MohamedAmr1312/3D-scanner/3D Scanner electrical system/3D Scanner_V02.png

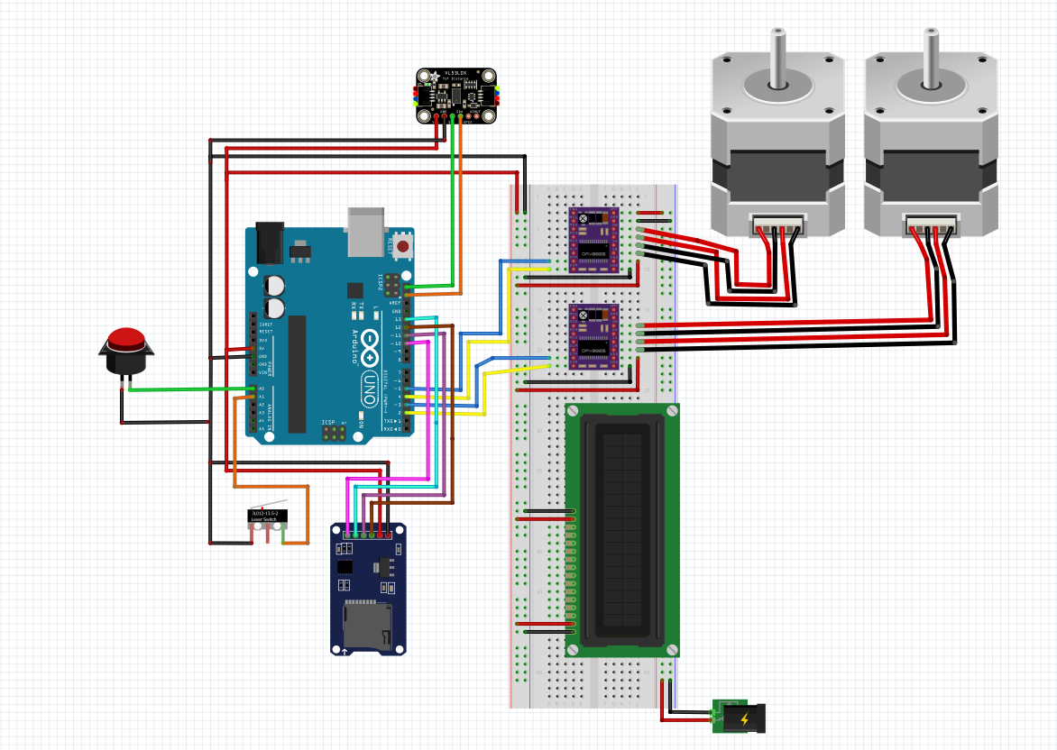
3D Scanner electrical system/3D Scanner_V02.png
