MohamedAmr1312/3D-scanner/mechanical design/3d scanner full/3d scanner full/stepper-motors-nema-23-1.snapshot.5/image.jpg

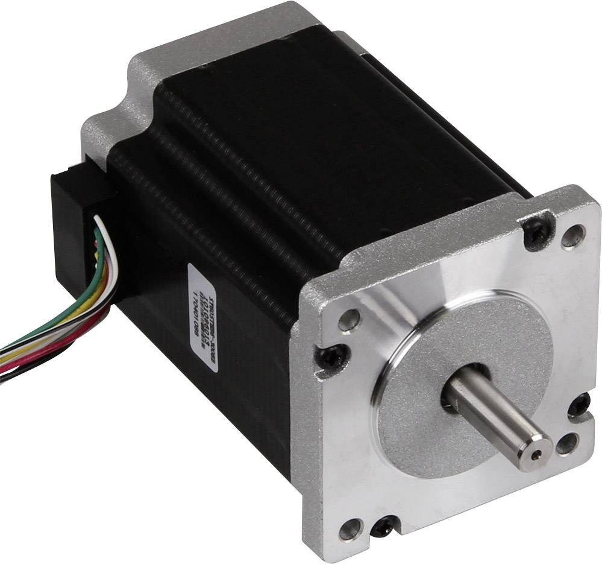
mechanical design/3d scanner full/3d scanner full/stepper-motors-nema-23-1.snapshot.5/image.jpg
