MohamedAmr1312/3D-scanner/Screenshot 2025-04-29 000141.png

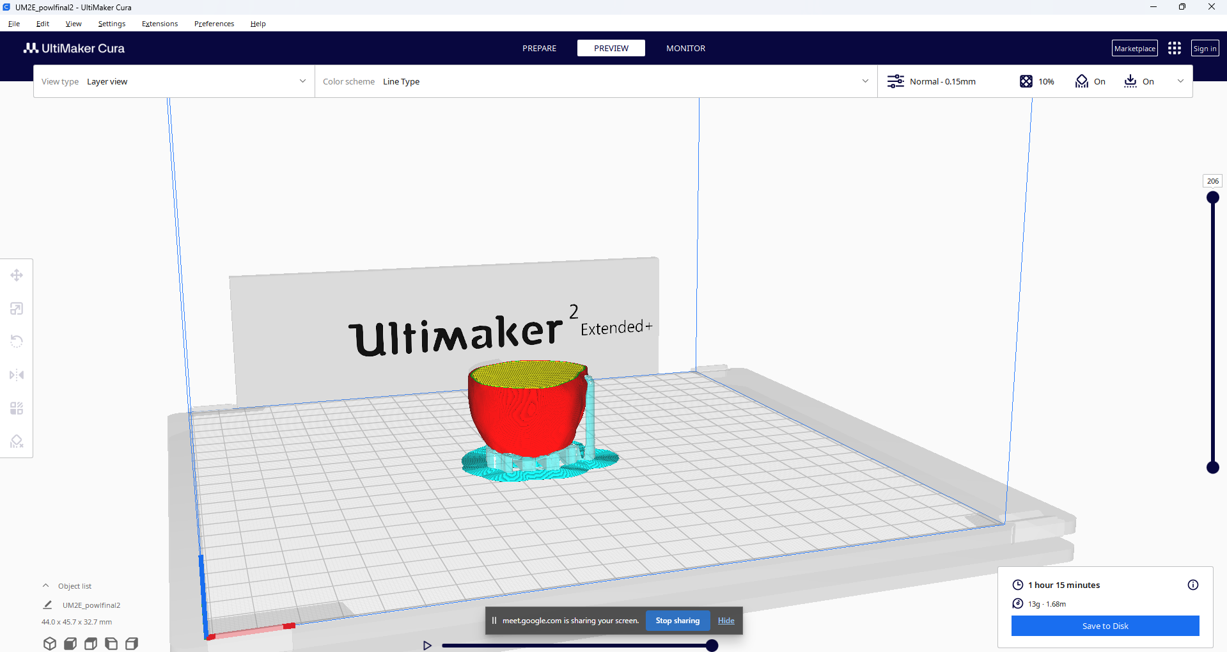
Screenshot 2025-04-29 000141.png
