MohamedAmr1312/3D-scanner/Screenshot 2025-04-29 000556.png

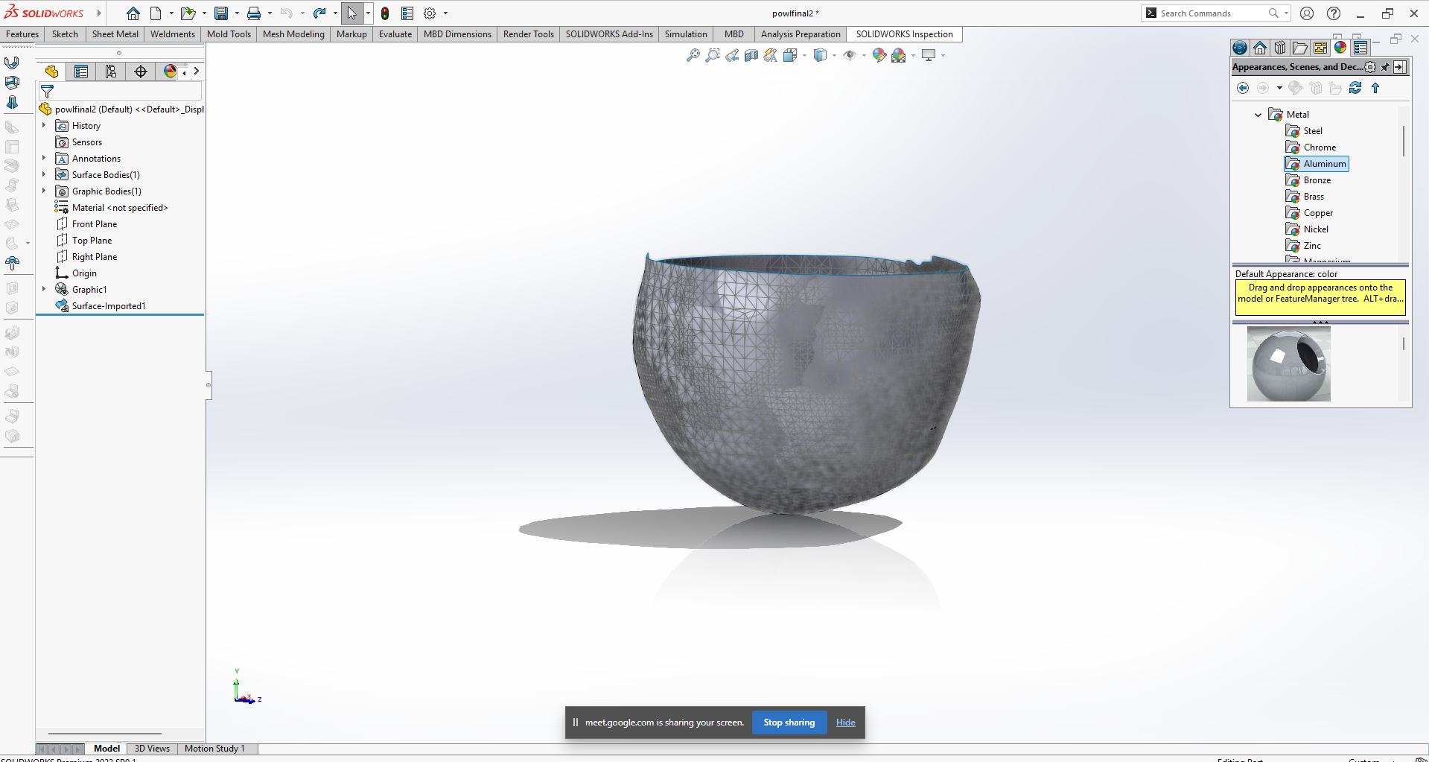
Screenshot 2025-04-29 000556.png
