MohamedAmr1312/3D-scanner/mechanical design/3d scanner full/3d scanner full/stepper-motors-nema-23-1.snapshot.5/fffff.SLDASM

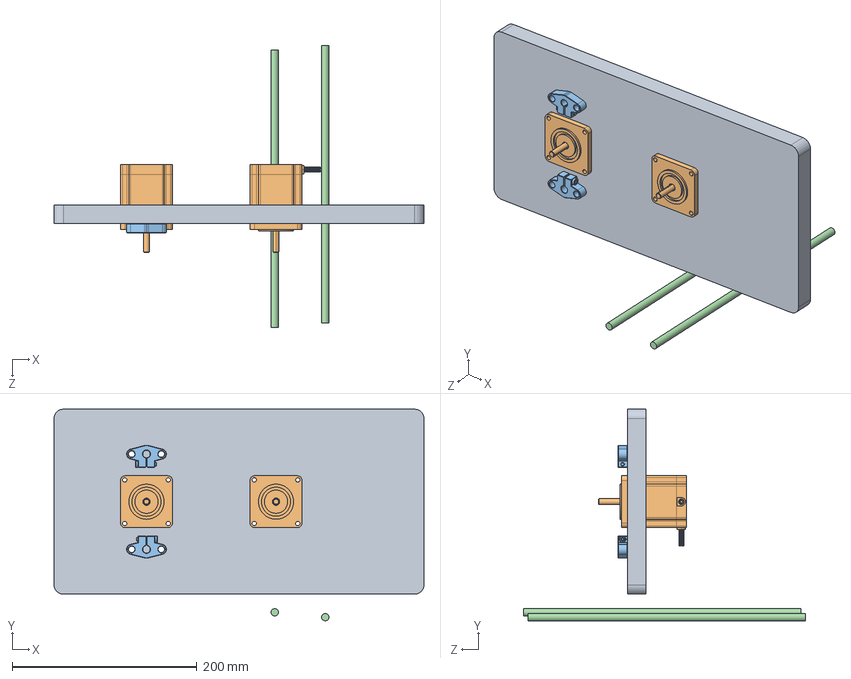
[picture p60: CAD file, 2025-05-02]
mechanical design/3d scanner full/3d scanner full/stepper-motors-nema-23-1.snapshot.5/fffff.SLDASM
400.0 x 228.9 x 304.8 mm
base
NEMA 23.step x 2
SHF8 x 2
Shaft-3mm Shaft x 2
