MohamedAmr1312/3D-scanner/mechanical design/3d scanner full/3d scanner full/Assem1.SLDASM

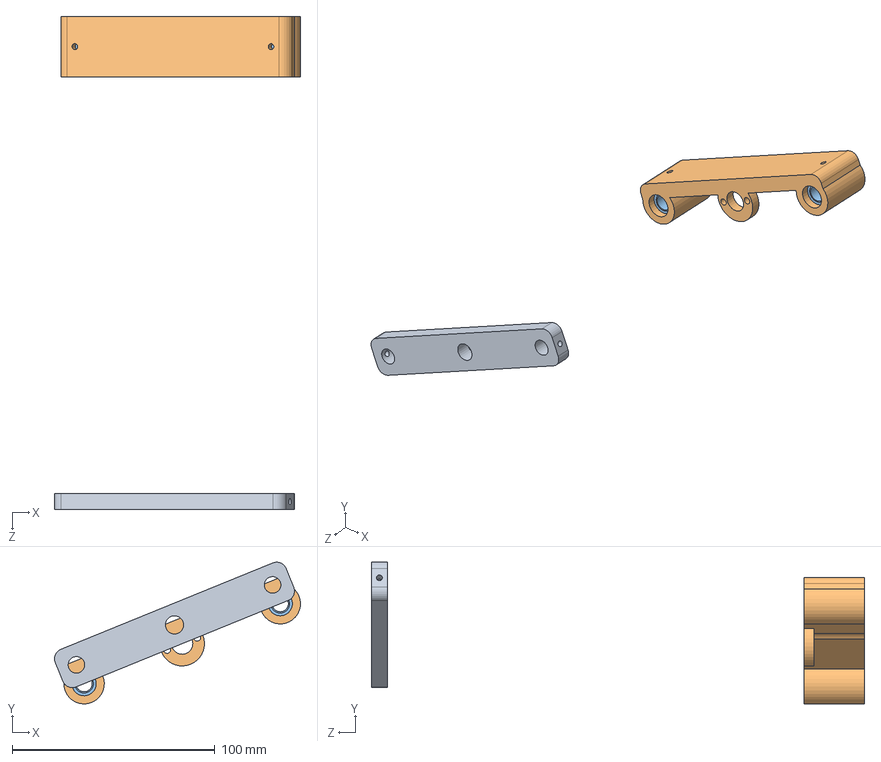
[picture p61: CAD file, 2025-05-02]
mechanical design/3d scanner full/3d scanner full/Assem1.SLDASM
121.3 x 69.9 x 243.4 mm
lm8uu x 2
movng supp ( bearing)
upper support
