MohamedAmr1312/3D-scanner/mechanical design/3d scanner full/3d scanner full/stepper-motors-nema-23-1.snapshot.5/fffffc new.SLDASM

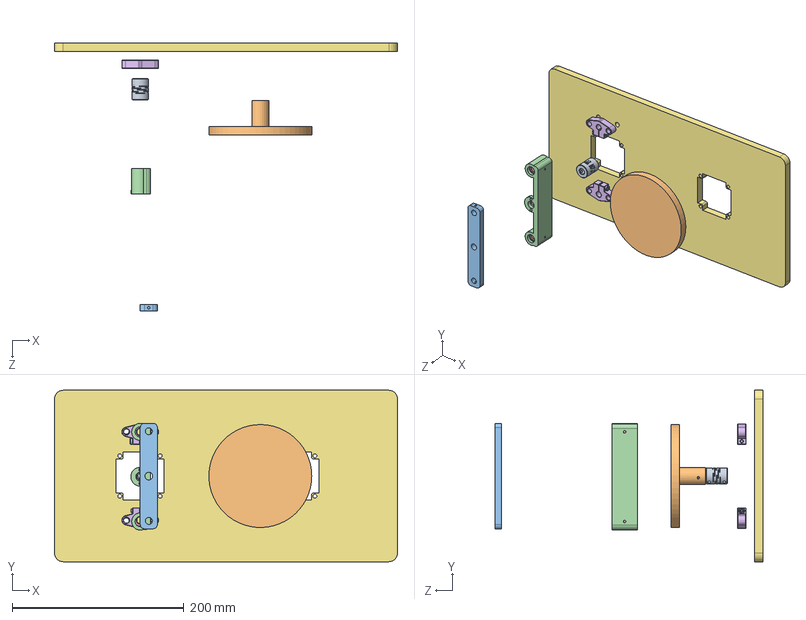
[picture p62: CAD file, 2025-05-02]
mechanical design/3d scanner full/3d scanner full/stepper-motors-nema-23-1.snapshot.5/fffffc new.SLDASM
400.0 x 200.0 x 313.0 mm
base
SHF8 x 2
lm8uu x 3
movng supp ( bearing)
upper support
rotating table
14 flex coupler
