MohamedAmr1312/3D-scanner/mechanical design/3d scanner full/3d scanner full/final 3d scanner.SLDASM

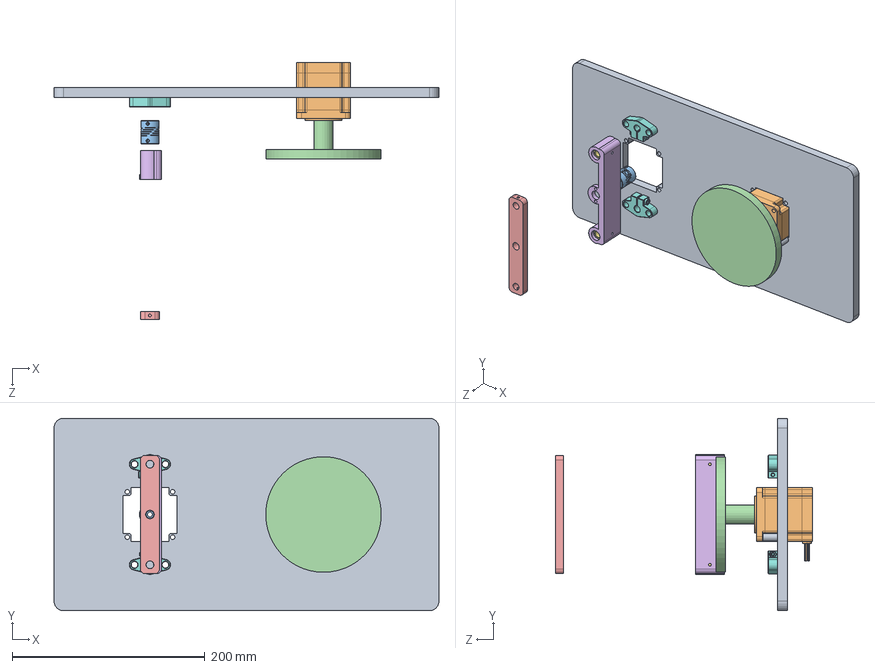
[picture p63: CAD file, 2025-05-02]
mechanical design/3d scanner full/3d scanner full/final 3d scanner.SLDASM
400.0 x 200.0 x 266.7 mm
base
SHF8 x 2
lm8uu x 2
movng supp ( bearing)
upper support
rotating table
14 flex coupler
NEMA 23 58
support for nema23
