MohamedAmr1312/3D-scanner/mechanical design/3d scanner full/3d scanner full/3d printing/rotating table without disk.STL

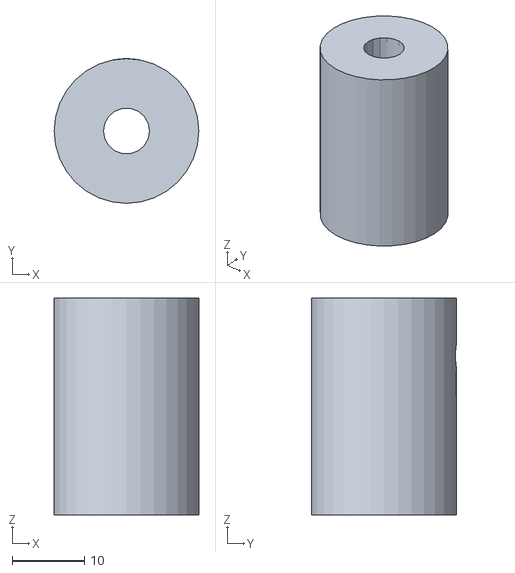
[picture p64: CAD file, 2025-05-02]
mechanical design/3d scanner full/3d scanner full/3d printing/rotating table without disk.STL
20.0 x 20.0 x 30.0
