MohamedAmr1312/3D-scanner/mechanical design/3d scanner full/3d scanner full/SHF8.SLDPRT

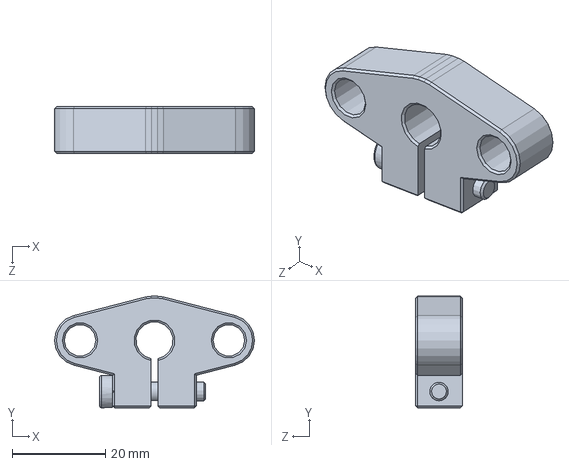
[picture p65: CAD file, 2025-05-02]
mechanical design/3d scanner full/3d scanner full/SHF8.SLDPRT
43.0 x 24.0 x 10.0 mm
