MohamedAmr1312/3D-scanner/mechanical design/step-motor-nema-23-2.snapshot.1/NEMA 23.stp

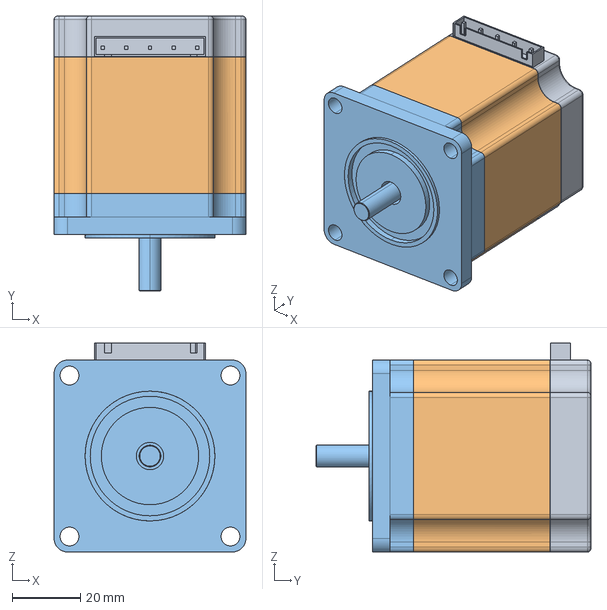
[picture p66: CAD file, 2025-05-02]
mechanical design/step-motor-nema-23-2.snapshot.1/NEMA 23.stp
56.2 x 80.5 x 61.2 mm
