MohamedAmr1312/3D-scanner/mechanical design/stepper-motors-nema-23-1.snapshot.5/NEMA 23.STEP

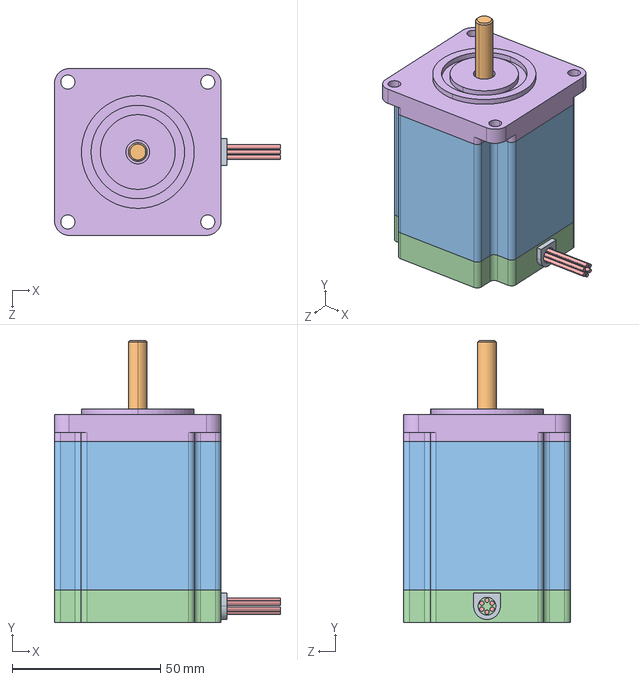
[picture p67: CAD file, 2025-05-02]
mechanical design/stepper-motors-nema-23-1.snapshot.5/NEMA 23.STEP
76.2 x 95.0 x 56.2 mm
