MohamedAmr1312/3D-scanner/mechanical design/3d scanner full/3d scanner full/3d printing/Motor Bracket.STL

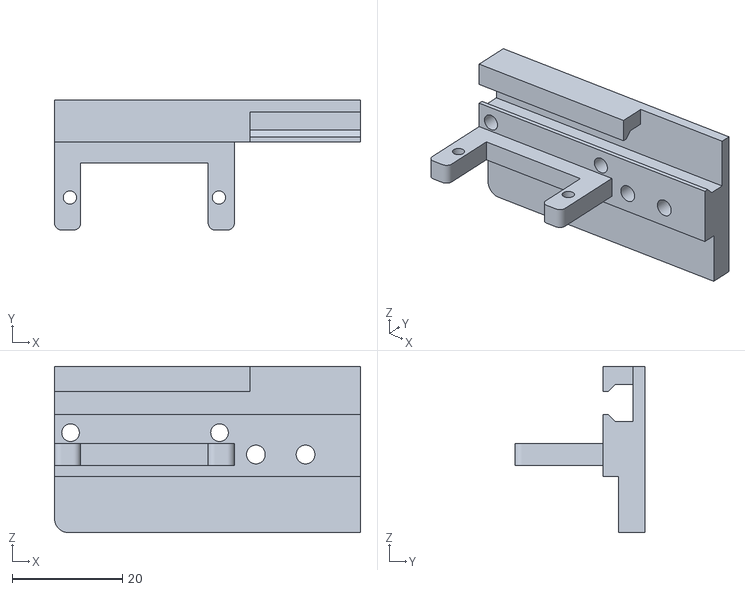
[picture p68: CAD file, 2025-05-02]
mechanical design/3d scanner full/3d scanner full/3d printing/Motor Bracket.STL
55.5 x 23.6 x 30.1
