MohamedAmr1312/3D-scanner/mechanical design/3d scanner full/3d scanner full/rotating table.SLDPRT

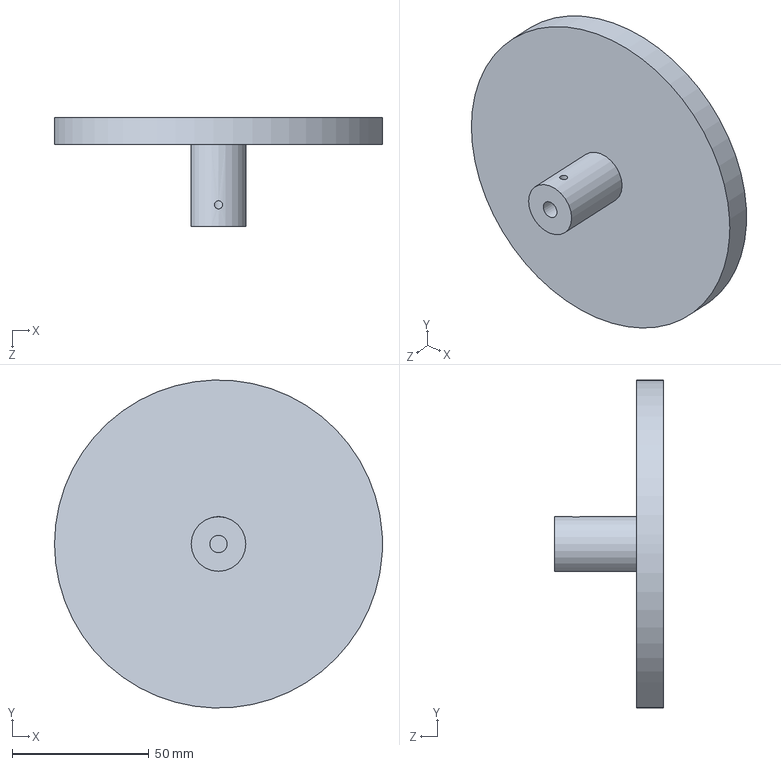
[picture p70: CAD file, 2025-05-02]
mechanical design/3d scanner full/3d scanner full/rotating table.SLDPRT
120.0 x 119.9 x 40.0 mm
