MohamedAmr1312/3D-scanner/mechanical design/3d scanner full/3d scanner full/stepper-motors-nema-23-1.snapshot.5/NEMA 23 58.SLDPRT

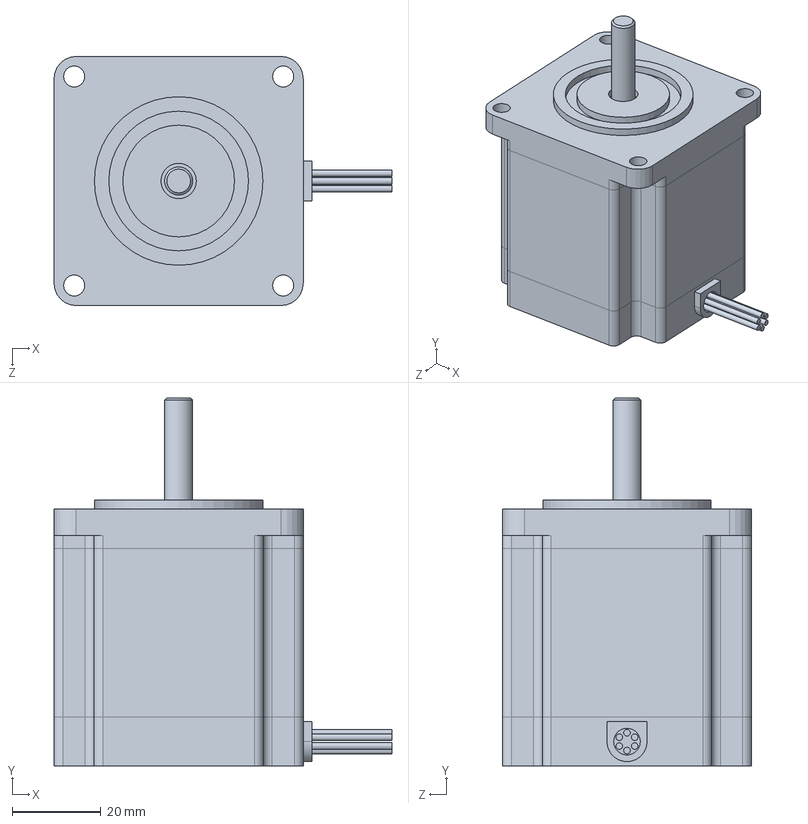
[picture p71: CAD file, 2025-05-02]
mechanical design/3d scanner full/3d scanner full/stepper-motors-nema-23-1.snapshot.5/NEMA 23 58.SLDPRT
76.2 x 83.0 x 56.2 mm
