MohamedAmr1312/3D-scanner/mechanical design/3d scanner full/3d scanner full/3d printing/UM3_3d scanner.3mf

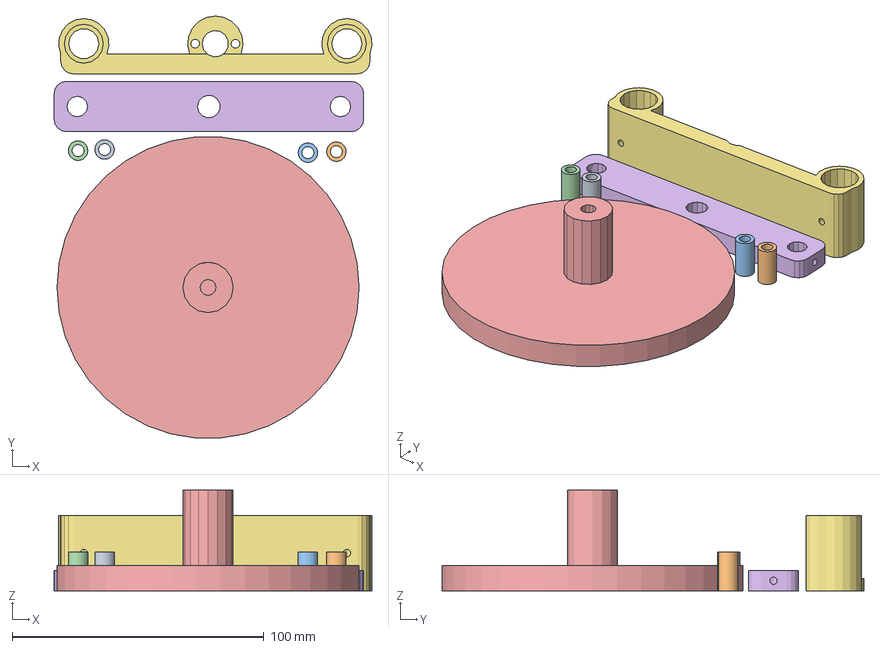
[picture p72: CAD file, 2025-05-02]
mechanical design/3d scanner full/3d scanner full/3d printing/UM3_3d scanner.3mf
126.3 x 167.6 x 40.0 mm
support for nema23.STL
support for nema23.STL(1)
support for nema23.STL(2)
support for nema23.STL(3)
rotating table.STL
upper support.STL
movng supp ( bearing).STL
