MohamedAmr1312/3D-scanner/mechanical design/3d scanner full/3d scanner full/VL6180X-Time_of_Flight_Sensor.stp

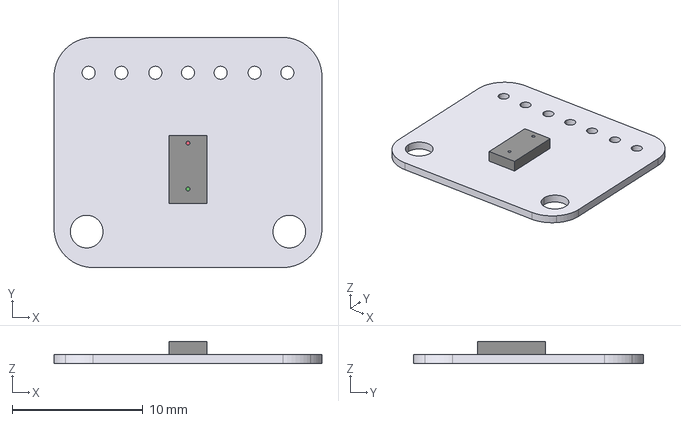
[picture p73: CAD file, 2025-05-02]
mechanical design/3d scanner full/3d scanner full/VL6180X-Time_of_Flight_Sensor.stp
20.5 x 17.6 x 1.71 mm
