MohamedAmr1312/3D-scanner/mechanical design/3d scanner full/3d scanner full/3d printing/Pusher, 75mm Long.STL

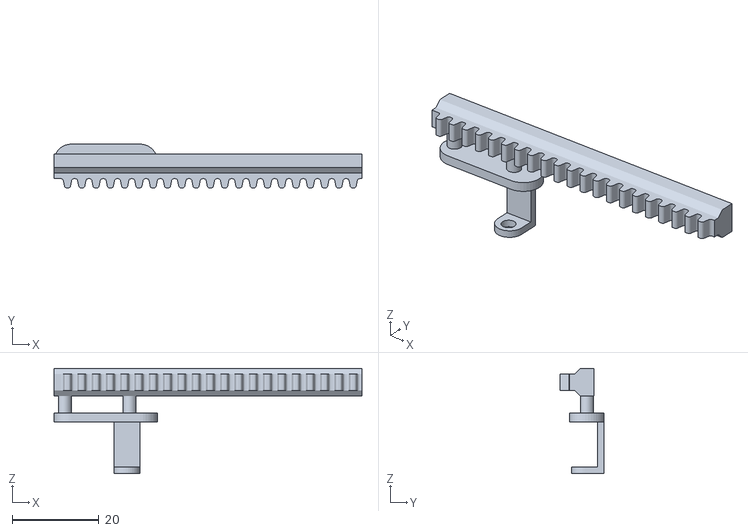
[picture p74: CAD file, 2025-05-02]
mechanical design/3d scanner full/3d scanner full/3d printing/Pusher, 75mm Long.STL
71.2 x 10.1 x 24.3
