MohamedAmr1312/3D-scanner/mechanical design/3d scanner full/3d scanner full/lm8uu.SLDPRT

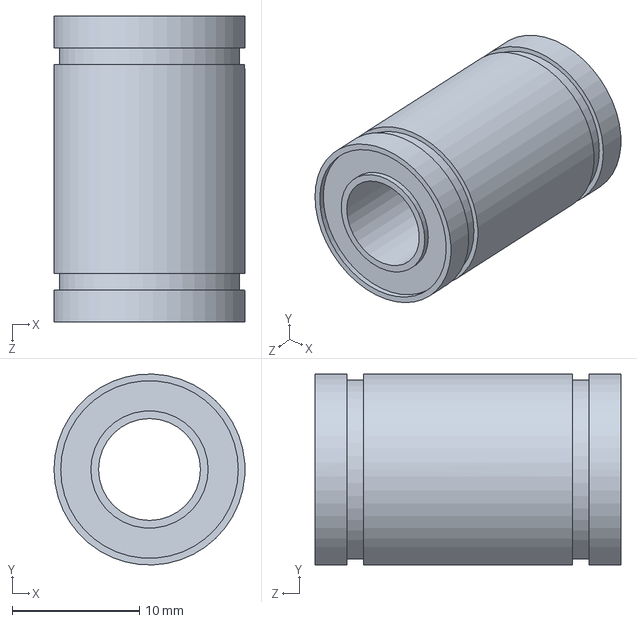
[picture p75: CAD file, 2025-05-02]
mechanical design/3d scanner full/3d scanner full/lm8uu.SLDPRT
15.0 x 15.0 x 24.0 mm
