MohamedAmr1312/3D-scanner/mechanical design/3d scanner full/3d scanner full/14 flex coupler.SLDPRT

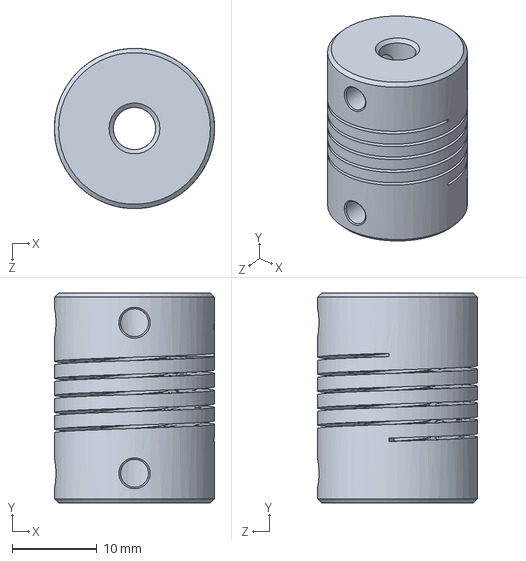
[picture p76: CAD file, 2025-05-02]
mechanical design/3d scanner full/3d scanner full/14 flex coupler.SLDPRT
18.9 x 24.8 x 18.9 mm
