MohamedAmr1312/3D-scanner/mechanical design/3d scanner full/3d scanner full/base.SLDPRT

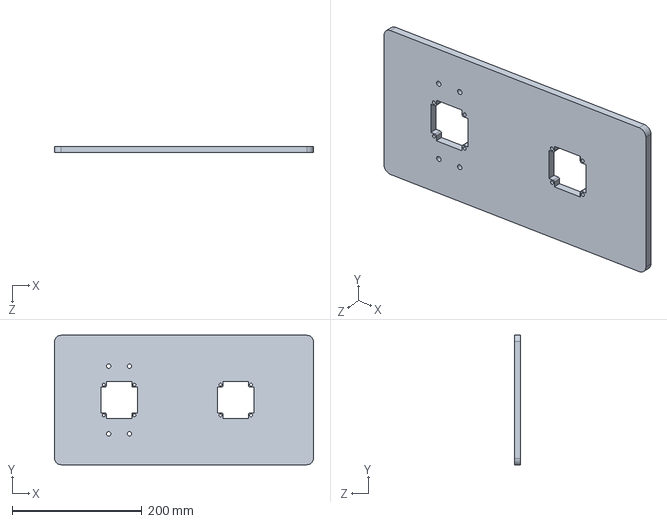
[picture p77: CAD file, 2025-05-02]
mechanical design/3d scanner full/3d scanner full/base.SLDPRT
400.0 x 200.0 x 10.0 mm
