MohamedAmr1312/3D-scanner/mechanical design/3d scanner full/3d scanner full/movng supp ( bearing).SLDPRT

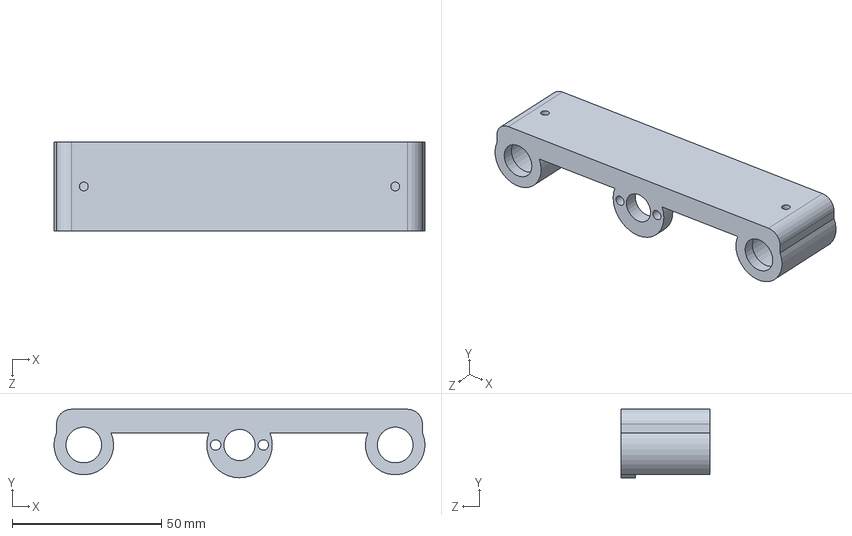
[picture p78: CAD file, 2025-05-02]
mechanical design/3d scanner full/3d scanner full/movng supp ( bearing).SLDPRT
124.5 x 23.0 x 30.0 mm
