MohamedAmr1312/3D-scanner/mechanical design/3d scanner full/3d scanner full/upper support.SLDPRT

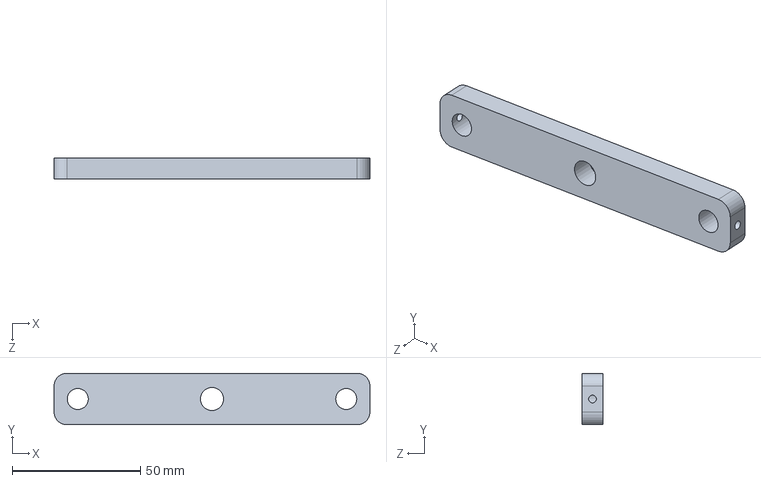
[picture p79: CAD file, 2025-05-02]
mechanical design/3d scanner full/3d scanner full/upper support.SLDPRT
123.0 x 20.0 x 8.00 mm
