MohamedAmr1312/3D-scanner/mechanical design/3d scanner full/3d scanner full/support for nema23.SLDPRT

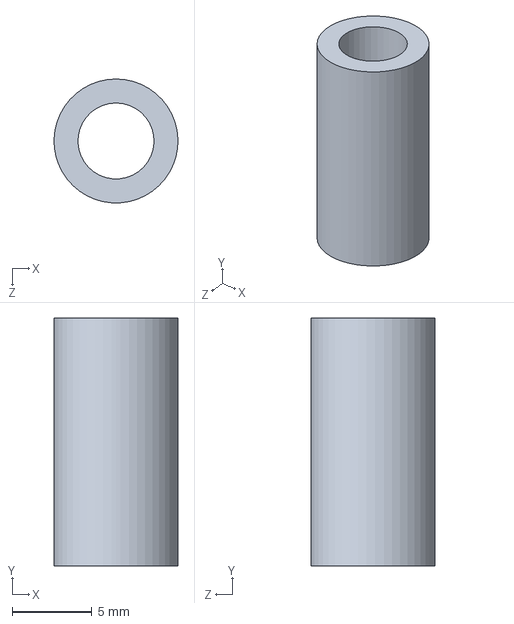
[picture p80: CAD file, 2025-05-02]
mechanical design/3d scanner full/3d scanner full/support for nema23.SLDPRT
7.75 x 15.5 x 7.75 mm
