MohamedAmr1312/3D-scanner/(list of files, cad)

Other CAD files:
mechanical design/stepper-motors-nema-23-1.snapshot.5/NEMA 23 42.SLDPRT
mechanical design/3d scanner full/3d scanner full/stepper-motors-nema-23-1.snapshot.5/NEMA 23 42.SLDPRT
mechanical design/3d scanner full/3d scanner full/3d printing/base.DXF
mechanical design/3d scanner full/3d scanner full/3d printing/movng supp ( bearing).STL
mechanical design/3d scanner full/3d scanner full/3d printing/rotating table.STL
mechanical design/3d scanner full/3d scanner full/3d printing/support for nema23.STL
mechanical design/3d scanner full/3d scanner full/3d printing/upper support.STL
mechanical design/3d scanner full/3d scanner full/screw & rod/rod 30cm.SLDPRT
mechanical design/3d scanner full/3d scanner full/screw & rod/screw 18 cm.SLDPRT
mechanical design/3d scanner full/3d scanner full/stepper-motors-nema-23-1.snapshot.5/NEMA 23.SLDPRT
mechanical design/screw & rod/rod 30cm.SLDPRT
mechanical design/screw & rod/screw 18 cm.SLDPRT
mechanical design/shf10-shf8-linear-shaft-support-1.snapshot.6/SHF10.IGS
mechanical design/shf10-shf8-linear-shaft-support-1.snapshot.6/SHF8.IGS
mechanical design/shf10-shf8-linear-shaft-support-1.snapshot.6/SHF8.SLDPRT
mechanical design/stepper-motors-nema-23-1.snapshot.5/NEMA 23.SLDPRT
