MohamedAmr1312/3D-scanner/mechanical design/step-motor-nema-23-2.snapshot.1/NEMA 23.JPG

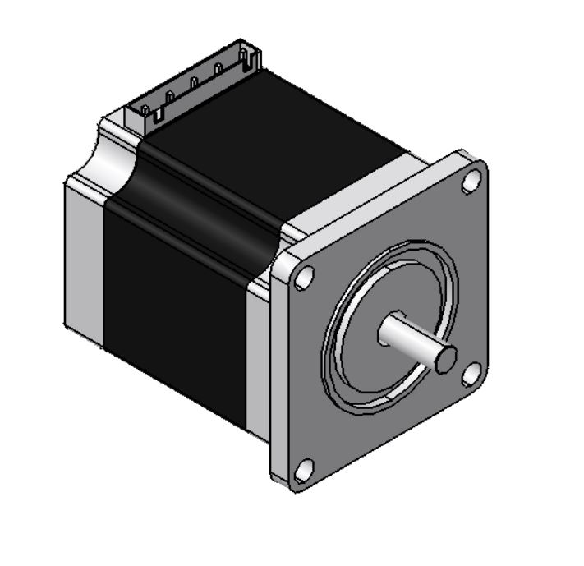
mechanical design/step-motor-nema-23-2.snapshot.1/NEMA 23.JPG
