MohamedAmr1312/3D-scanner/(list of files, drawings)

Other design files:
3D Scanner electrical system/3D Scanner.pdsprj
3D Scanner electrical system/3D Scanner_Schematic.fzz
